razagoat12/Field-Test/assets/field_days_dark.png

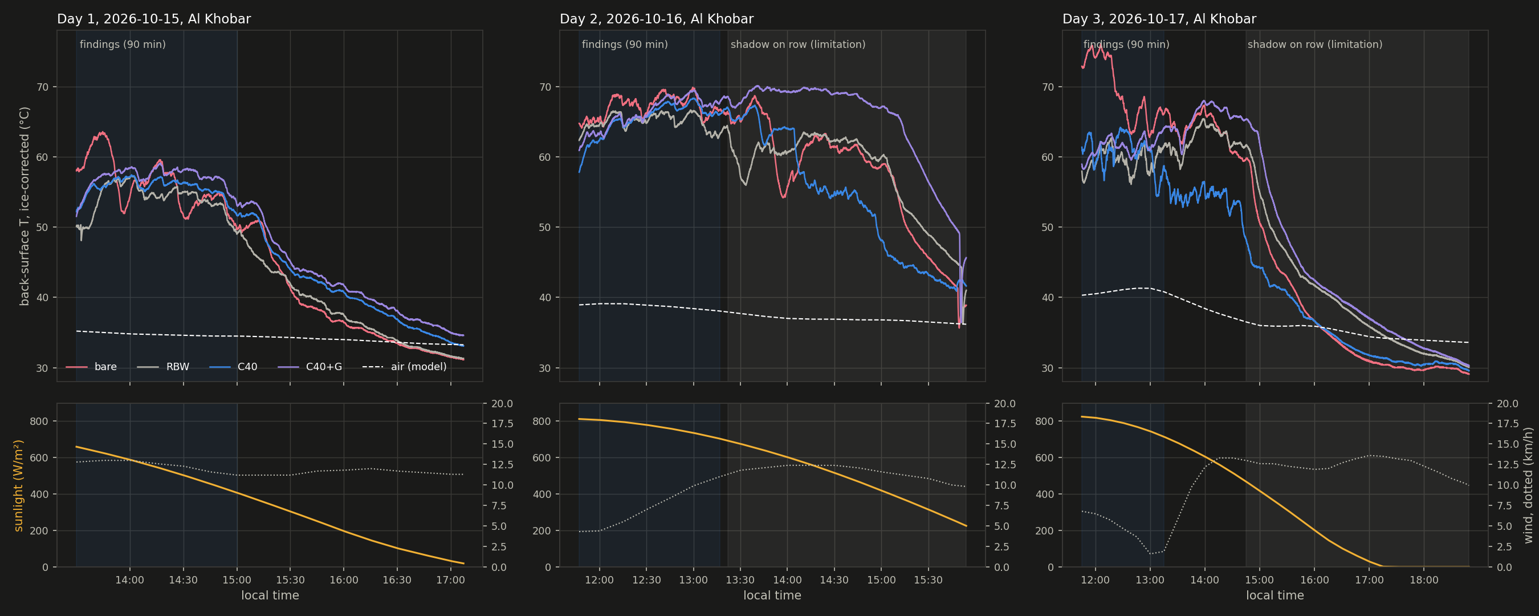
assets/field_days_dark.png
