razagoat12/Field-Test/assets/field_summary_dark.png

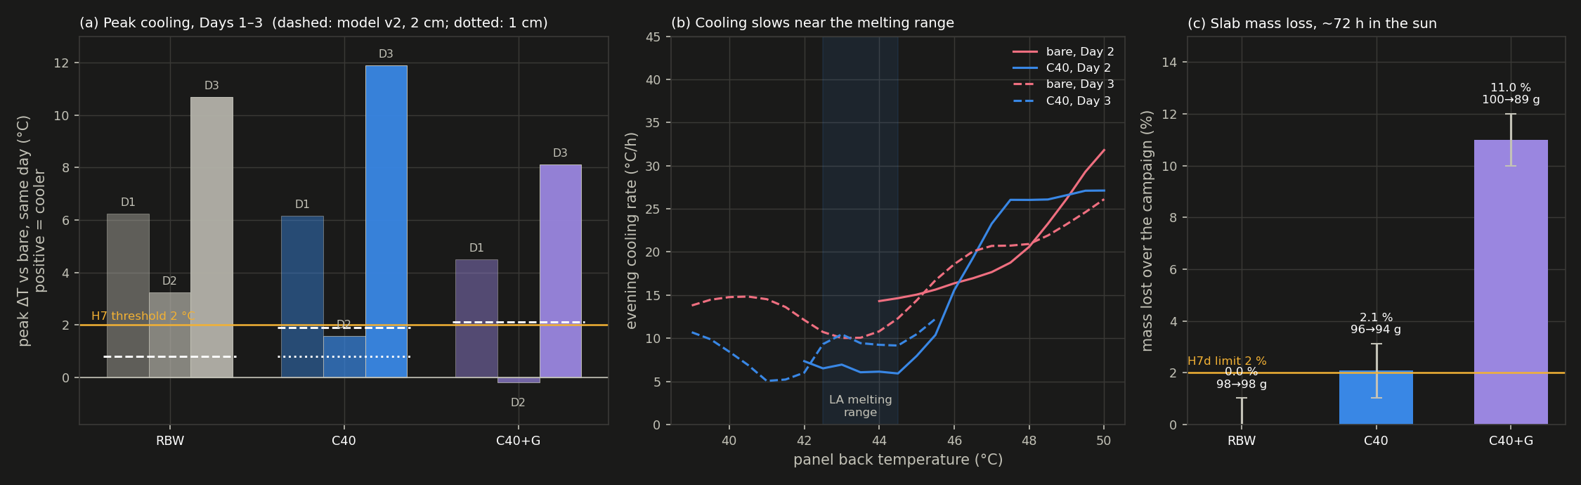
assets/field_summary_dark.png
