razagoat12/Field-Test/Hardware/field_test_circuit_sim.html

# Field-test circuit simulator

3 × Arduino Uno · 7 × DS18B20 · 2 × DS3231 · 3 × pull-up · breadboards

Simulated data – not results

Start Day layout Speed Pause Plug in USB --
