razagoat12/Field-Test/(commit log)

2026-10-15 Field test: firmware, logging, calibration, pilot data and README
    - Hardware/: Uno field logger, calibration sketch, ESP32 Wi-Fi logger,
    serial/HTTP loggers, run script and earlier sketches.
    - Hardware/logs/: 15 Oct 2026 pilot run (four panels in sun, raw values).
    - docs/calibration.md: ice-offset calibration with held-out room check.
    - model/pcm_panel_model.py: pre-registered panel thermal model for H7.
    - analysis/plot_pilot.py and assets/: pilot figures (light and dark).
    [pilot_2026-10-15.csv]
2026-10-17 Correct station labels; add Day 2, weather and v2 model
    Day 1 was labelled by breadboard order; the finger test of 16 Oct shows
    S0 graphite, S1 C40, S2 RBW, S3 bare. Header and column names fixed,
    data rows untouched. Day 2 (16 Oct) added with its raw transcript, plus
    Open-Meteo weather for Al Khobar.
    New analysis/field_analysis.py replaces plot_pilot.py (whose figures
    carried the wrong labels): 90-min findings window, full record kept,
    matched-sunlight comparison. Model v2 (radiation, insulated back) added;
    v1 kept as recorded. README, run script and calibration doc now describe
    the test as run: Al Khobar, mini panels, 2 cm slabs, no containers.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
    [day2_2026-10-16.csv, pilot_2026-10-15.csv, weather_alkhobar_2026-10-15_16.csv]
2026-10-17 Add Day 3, slab masses and three-day results
    Day 3 (17 Oct, 11:45-18:49) raw and clean logs and weather; slabs
    14x7x1 cm; masses RBW 0 %, C40 2.1 %, C40+G 11 %. Analysis adds the
    pre-registered per-day peak comparison, evening cooling rates and a
    summary figure; README and run script updated; station photos.
    [day3_2026-10-17.csv, weather_alkhobar_2026-10-17.csv]
